ozboar/hardware_modules/README.md

# Hardware Modules
A repository for custom open-source hardware modules, for various keyboards.

* [One Key module without LED](/modules/without-led/README.md)
* [Zoom65 V3 ScreenKey MX module](/modules/Zoom65v3/screenkey-mx/README.md) (work in progress)
