ozboar/hardware_modules/modules/Zoom65v3/screenkey-mx/Kicad/production/bom.csv

Comment | Designator | Footprint | Quantity | MPN | LCSC Part #
100n | C1 | C_0603_1608Metric | 1 | CC0603KRX7R9BB104 | C14663
10u | C2,C3 | C_0603_1608Metric | 2 | CL10A106KP8NNNC | C19702
FH34SRJ-12S-0.5SH(50) | J1 | Hirose_FH34SRJ-12S-0.5SH | 1 | FH34SRJ-12S-0.5SH(50) | C424659
FH34SRJ-14S-0.5SH(50) | J2 | Hirose_FH34SRJ-14S-0.5SH | 1 | FH34SRJ-14S-0.5SH(50) | C324724
2u2 | L1 | L_Murata_DFE201610P | 1 | DFE201612P-2R2M=P2 | C79317
5R1 | R1 | R_0603_1608Metric | 1 | 0603WAF510KT5E | C25197
100k | R2 | R_0603_1608Metric | 1 | 0603WAF1003T5E | C25803
10k | R3,R4 | R_0603_1608Metric | 2 | 0603WAF1002T5E | C25804
PAM2804AAB010 | U1 | SOT-23-5 | 1 | PAM2804AAB010 | C71463
