ozboar/hardware_modules/modules/Zoom65v3/screenkey-mx/docs/module-assembly.step

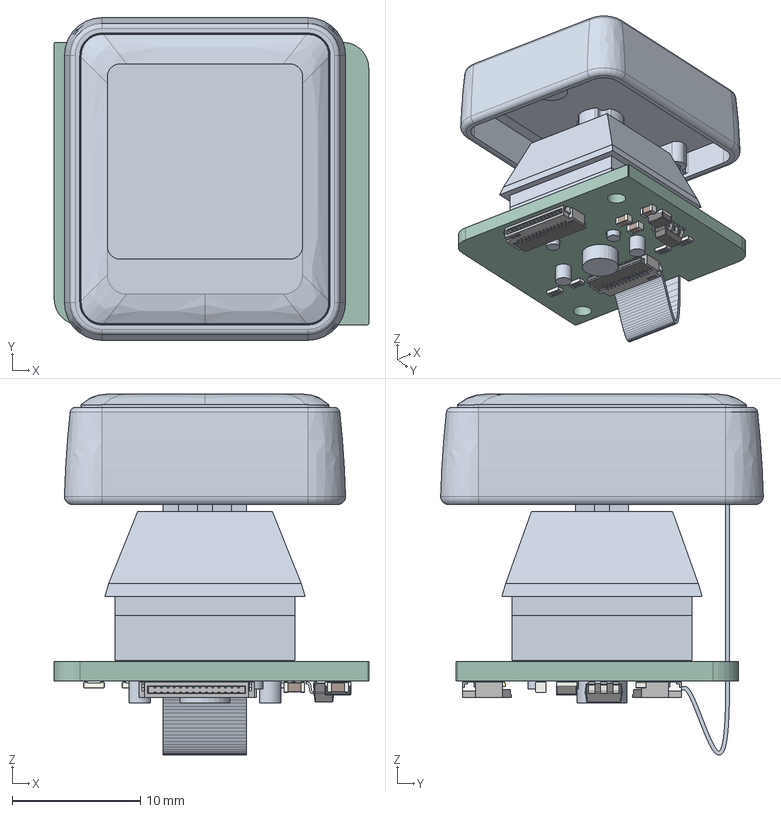
[picture p7: CAD file, 2026-11-06]
modules/Zoom65v3/screenkey-mx/docs/module-assembly.step
24.5 x 25.1 x 28.1 mm
FFC-SMD_14P-P0.50_FH34SRJ-14S-0.5SH
C_0603_1608Metric x 3
R_0603_1608Metric x 4
L_Murata_DFE201610P
SOT-23-5
FFC-SMD_12P-P0.50_FH34SRJ-12S-0.5SH
Zoom65v3-screenkey_PCB
