ozboar/hardware_modules/modules/Zoom65v3/screenkey-mx/Kicad/3d/FH34SRJ-14S-0.5SH.step

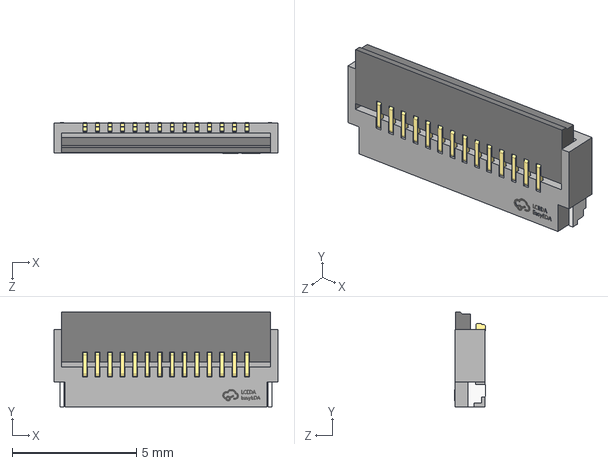
[picture p8: CAD file, 2026-11-06]
modules/Zoom65v3/screenkey-mx/Kicad/3d/FH34SRJ-14S-0.5SH.step
9.00 x 3.80 x 1.23 mm
