ozboar/hardware_modules/modules/Zoom65v3/screenkey-mx/Kicad/3d/ribbon-flex.step

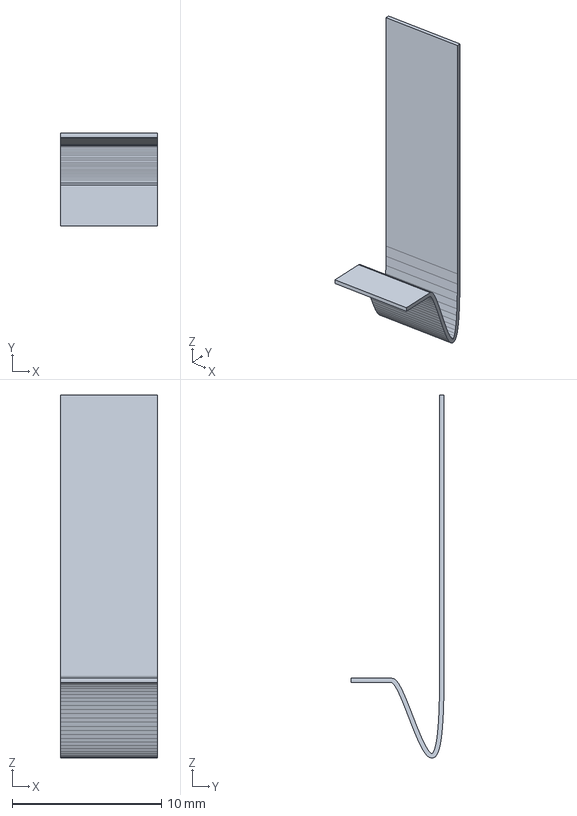
[picture p9: CAD file, 2026-11-06]
modules/Zoom65v3/screenkey-mx/Kicad/3d/ribbon-flex.step
6.50 x 6.24 x 24.4 mm
