ozboar/hardware_modules/modules/Zoom65v3/screenkey-mx/Kicad/3d/mx-switch-keycap.step

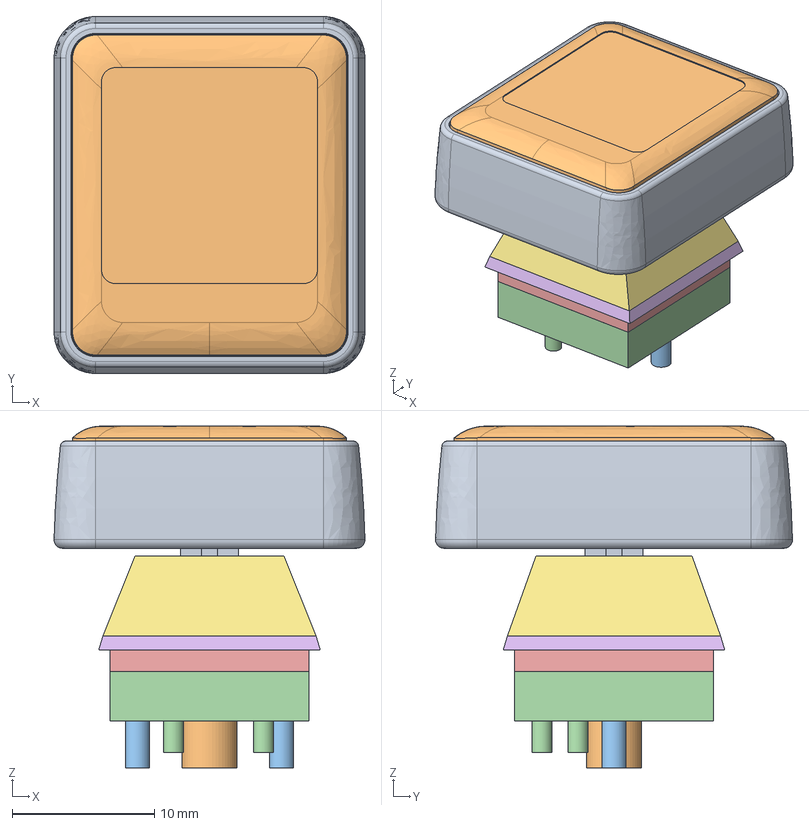
[picture p10: CAD file, 2026-11-06]
modules/Zoom65v3/screenkey-mx/Kicad/3d/mx-switch-keycap.step
21.9 x 25.1 x 24.1 mm
