ozboar/hardware_modules/modules/Zoom65v3/screenkey-mx/docs/schematic.pdf

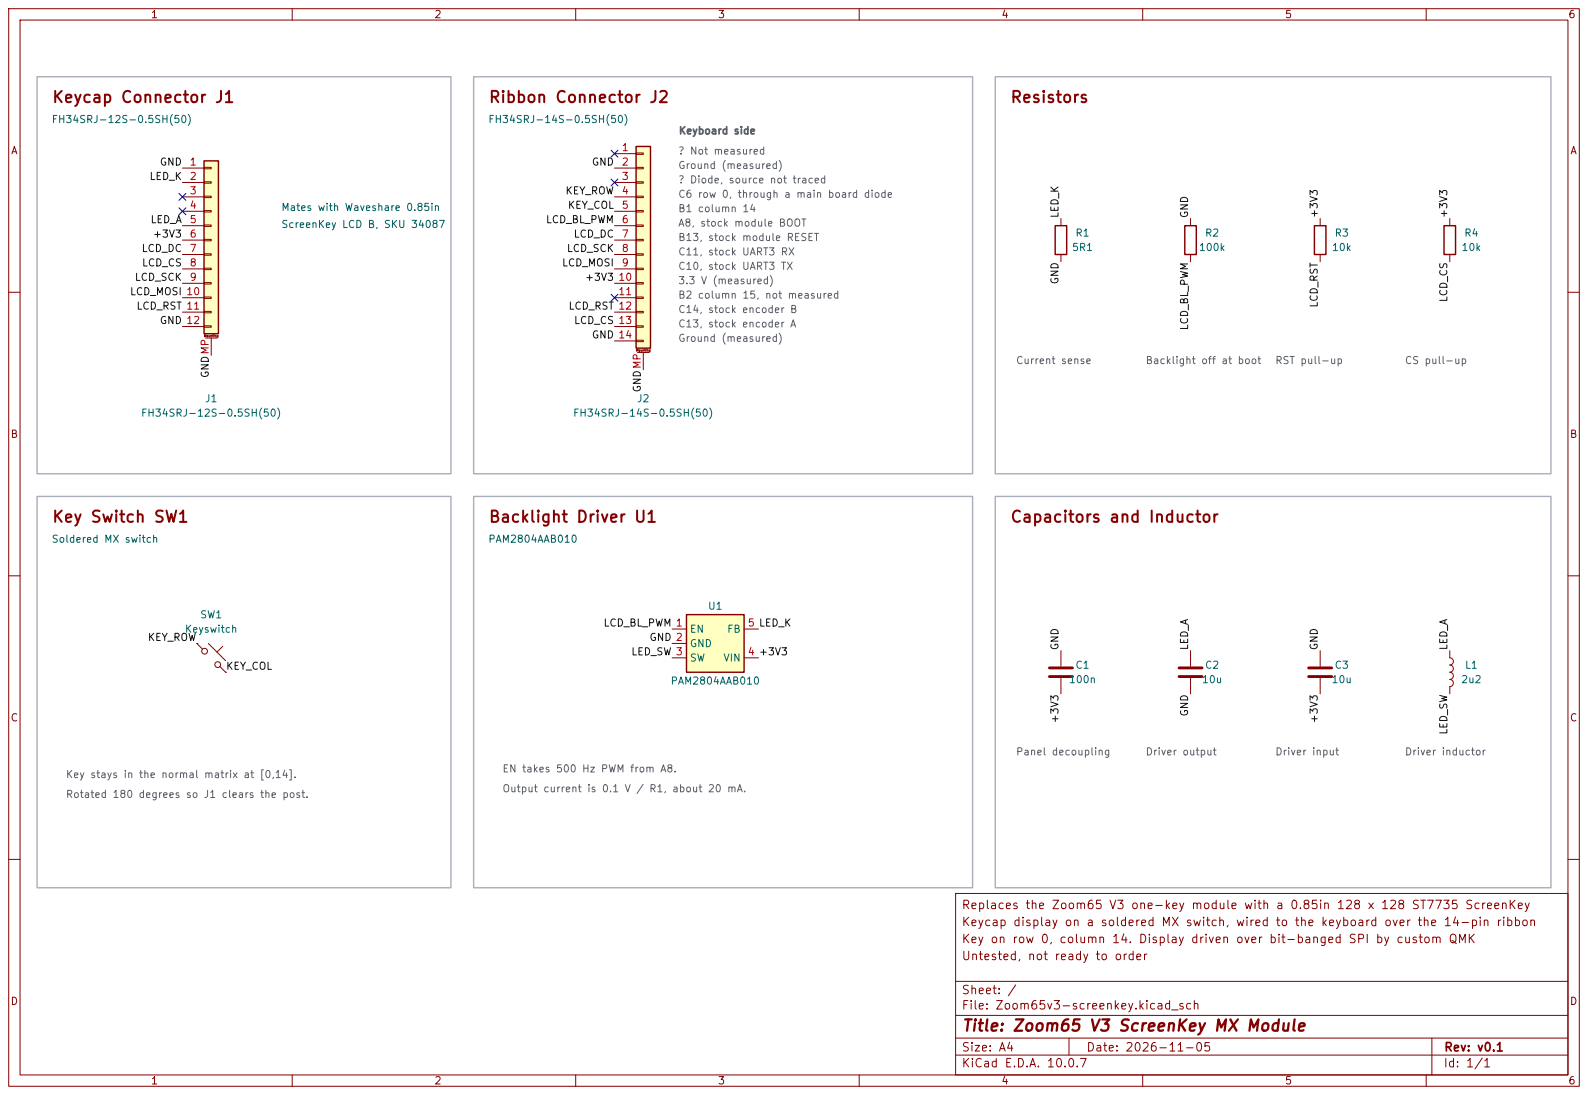
[picture p11: page 1]

? Not measured Ground (measured) ? Diode, source not traced C6 row 0, through a main board diode B1 column 14

A8, stock module BOOT B13, stock module RESET C11, stock UART3 RX

C13, stock encoder A Ground (measured)

Replaces the Zoom65 V3 one-key module with a 0.85in 128 x 128 ST7735 ScreenKey C2

EN takes 500 Hz PWM from A8. Output current is 0.1 V / R1, about 20 mA. Key stays in the normal matrix at [0,14].

Keycap display on a soldered MX switch, wired to the keyboard over the 14-pin ribbon
Key on row 0, column 14. Display driven over bit-banged SPI by custom QMK
Untested, not ready to order

Sheet: /
File: Zoom65v3-screenkey.kicad_sch
Title: Zoom65 V3 ScreenKey MX Module

Size: A4 | Rev: v0.1
KiCad E.D.A. 10.0.7 | Id: 1/1
