ozboar/hardware_modules/modules/Zoom65v3/screenkey-mx/docs/pcb-layout.pdf

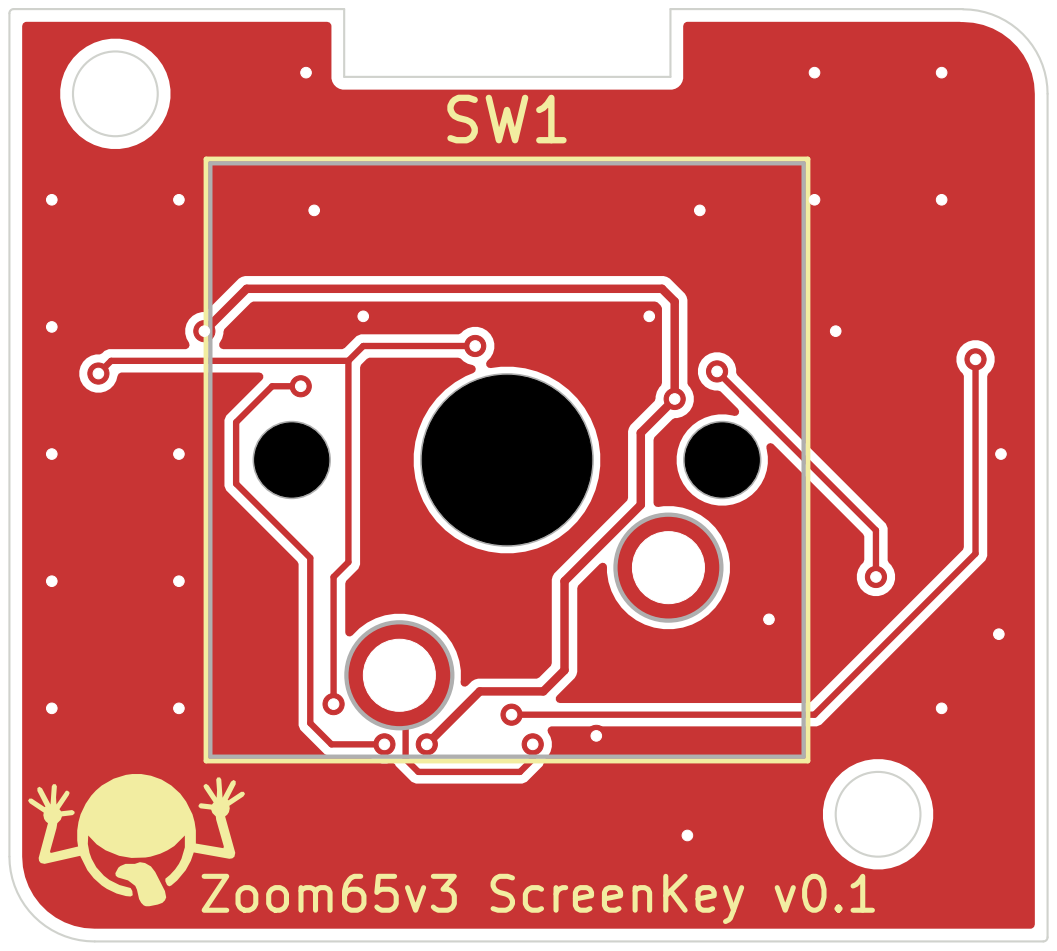
[picture p12: page 1]
D Date: 2026-11-05; KiCad E.D.A. 10.0.7; Size: A4; Rev: v0.1; Zoom65v3 ScreenKey v0.1

Sheet:
File: Zoom65v3-screenkey.kicad_pcb
Title: Zoom65 V3 ScreenKey MX Module

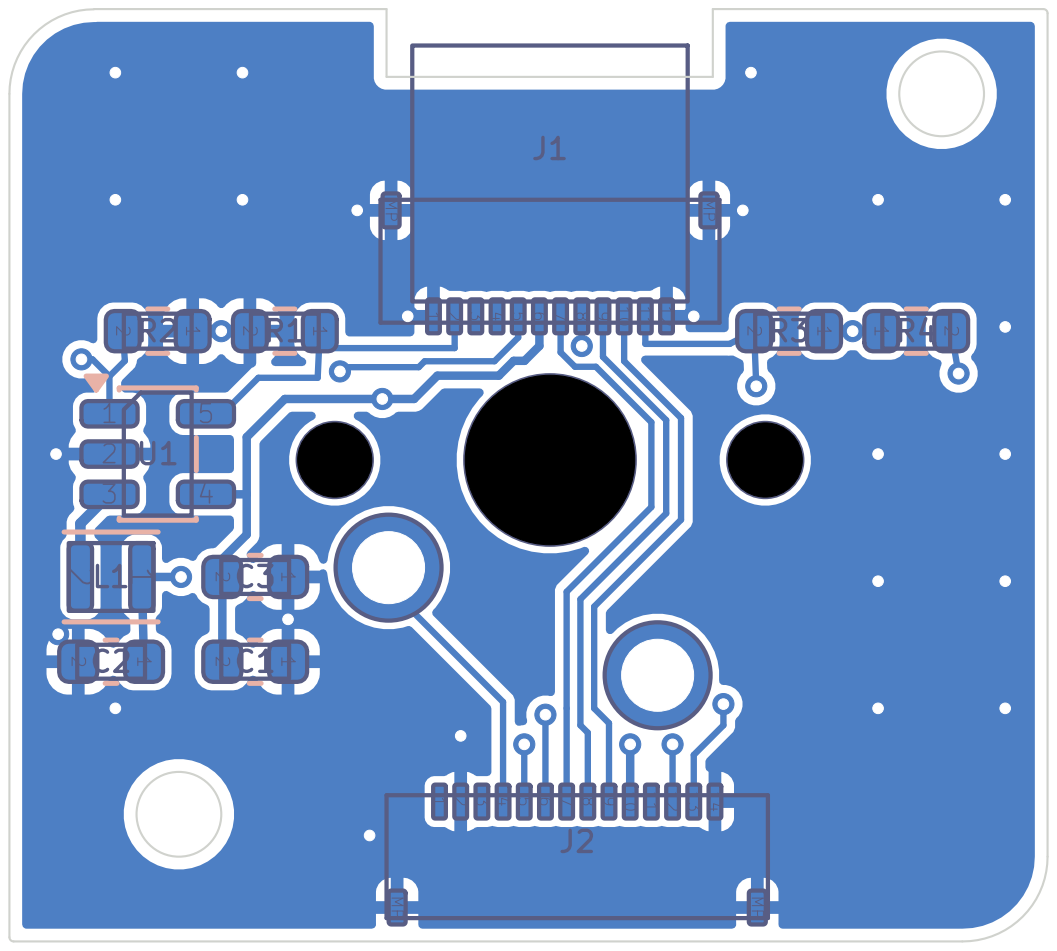
[picture p13: page 2]

Sheet:
File: Zoom65v3-screenkey.kicad_pcb
Title: Zoom65 V3 ScreenKey MX Module
