ozboar/hardware_modules/modules/Zoom65v3/screenkey-mx/docs/ScreenKey-Module-drawing.pdf

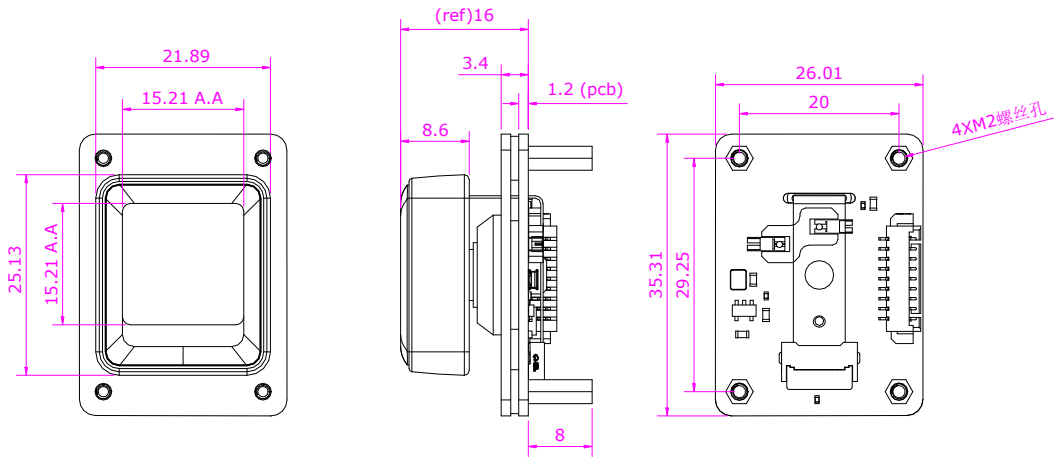
[picture p14: page 1]
1.2 (pcb); (ref)16; 4XM2螺丝孔
