ozboar/hardware_modules/modules/Zoom65v3/screenkey-mx/Kicad/Zoom65v3-screenkey.kicad_pcb

## KiCad design modules/Zoom65v3/screenkey-mx/Kicad/Zoom65v3-screenkey.kicad_pcb (2026-11-06)

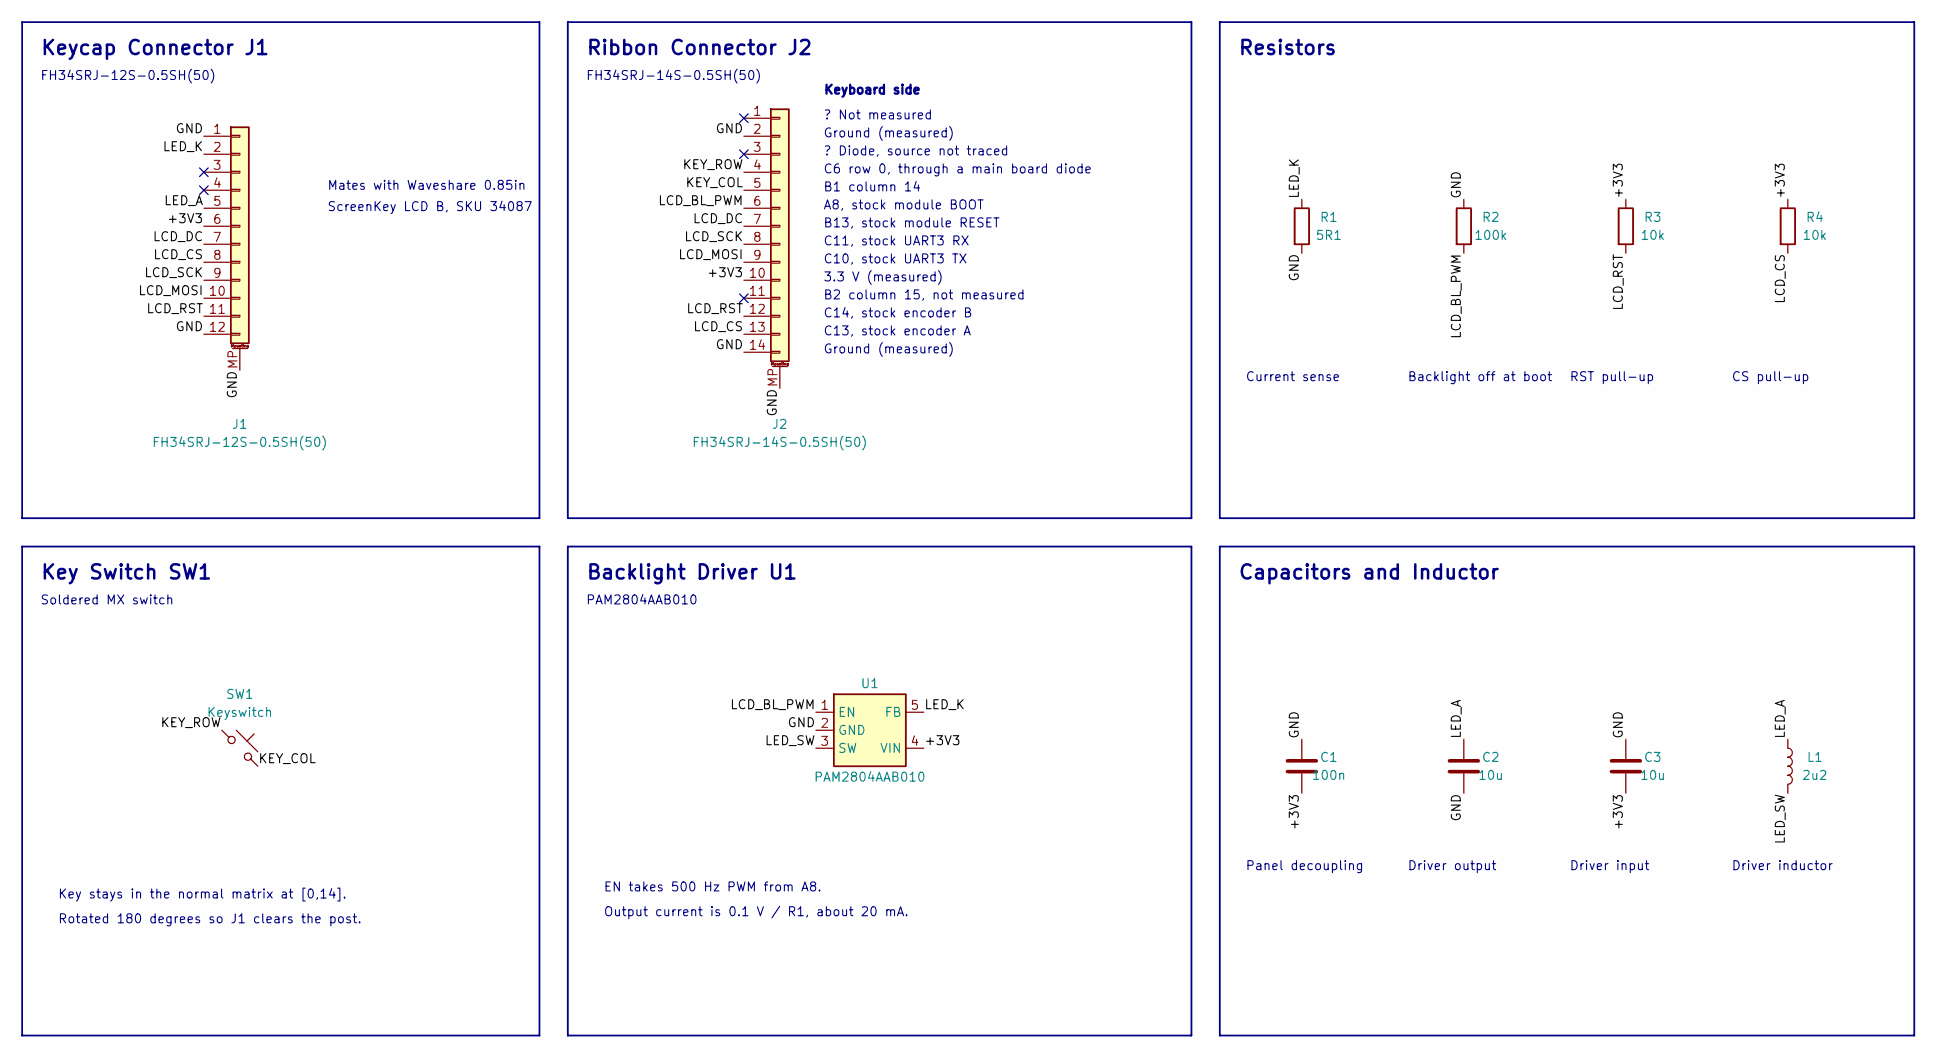
[picture p15: schematic Zoom65v3-screenkey.kicad_sch, Zoom65 V3 ScreenKey MX Module]

Parts:
C1: 100n; C_0603_1608Metric; MPN CC0603KRX7R9BB104; LCSC C14663
C2, C3: 10u; C_0603_1608Metric; MPN CL10A106KP8NNNC; LCSC C19702
J1: FH34SRJ-12S-0.5SH(50); Hirose_FH34SRJ-12S-0.5SH; MPN FH34SRJ-12S-0.5SH(50); LCSC C424659
J2: FH34SRJ-14S-0.5SH(50); Hirose_FH34SRJ-14S-0.5SH; MPN FH34SRJ-14S-0.5SH(50); LCSC C324724
L1: 2u2; L_Murata_DFE201610P; MPN DFE201612P-2R2M=P2; LCSC C79317
R1: 5R1; R_0603_1608Metric; MPN 0603WAF510KT5E; LCSC C25197
R2: 100k; R_0603_1608Metric; MPN 0603WAF1003T5E; LCSC C25803
R3, R4: 10k; R_0603_1608Metric; MPN 0603WAF1002T5E; LCSC C25804
SW1: Keyswitch; SW_MX_PTH
U1: PAM2804AAB010; SOT-23-5; MPN PAM2804AAB010; LCSC C71463

Connections:
/+3V3: C1.2, C3.2, J1.6, J2.10, R3.1, R4.1, U1.4
/GND: C1.1, C2.2, C3.1, J1.1, J1.12, J1.MP, J2.2, J2.14, J2.MP, R1.2, R2.1, U1.2
/KEY_COL: J2.5, SW1.2
/KEY_ROW: J2.4, SW1.1
/LCD_BL_PWM: J2.6, R2.2, U1.1
/LCD_CS: J1.8, J2.13, R4.2
/LCD_DC: J1.7, J2.7
/LCD_MOSI: J1.10, J2.9
/LCD_RST: J1.11, J2.12, R3.2
/LCD_SCK: J1.9, J2.8
/LED_A: C2.1, J1.5, L1.1
/LED_K: J1.2, R1.1, U1.5
/LED_SW: L1.2, U1.3

Notes on the sheet:
Keycap Connector J1
FH34SRJ-12S-0.5SH(50)
Ribbon Connector J2
FH34SRJ-14S-0.5SH(50)
Resistors
Key Switch SW1
Soldered MX switch
Backlight Driver U1
PAM2804AAB010
Capacitors and Inductor
Mates with Waveshare 0.85in
ScreenKey LCD B, SKU 34087
Keyboard side
? Not measured
Ground (measured)
? Diode, source not traced
C6 row 0, through a main board diode
B1 column 14
A8, stock module BOOT
B13, stock module RESET
C11, stock UART3 RX
C10, stock UART3 TX
3.3 V (measured)
B2 column 15, not measured
C14, stock encoder B
C13, stock encoder A
Key stays in the normal matrix at [0,14].
Rotated 180 degrees so J1 clears the post.
EN takes 500 Hz PWM from A8.
Output current is 0.1 V / R1, about 20 mA.
Current sense
Backlight off at boot
RST pull-up
CS pull-up
Panel decoupling
Driver output
Driver input
Driver inductor

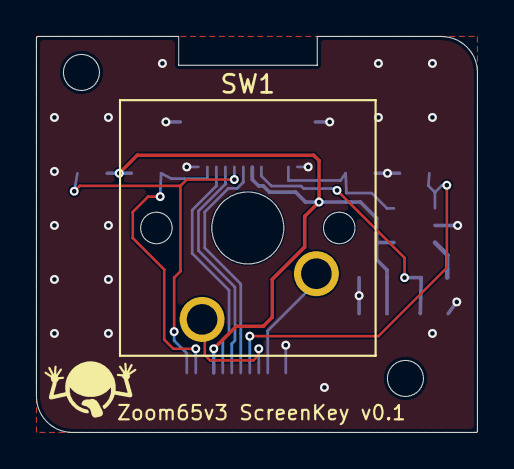
[picture p16: board Zoom65v3-screenkey.kicad_pcb from above]

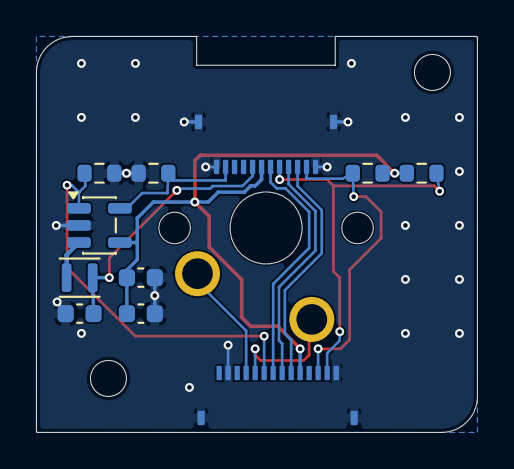
[picture p17: board Zoom65v3-screenkey.kicad_pcb from below]

Board: 2 copper layers, 24.5 x 22.0 mm, 12 parts (11 on the bottom side), 13 nets.
